sp5idc/ocfd_pota/(list of files, drawings)

Other design files:
src/ProDoc_OCFD_POTa_2026-03-04.epro
