sp5idc/ocfd_pota/(commit log)

2026-02-24 Adding files
    [ProPrj_OCFD POTa_2026-02-24.epro]
2026-02-24 Updated project files with OSH logo
    [ProPrj_OCFD POTa_2026-02-24.epro]
2026-03-04 Added new version of PCB
    [ProDoc_OCFD_POTa_2026-03-04.epro, ProPrj_OCFD POTa_2026-02-24.epro]
2026-03-05 Replace graphics with actual version of PCB
2026-03-15 Update README_pl.md
    Added info about wire length
2026-03-15 Update README.md
    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
